xanderhendriks/pcb-tv-slider/README.md

# Starting KiCAD
Run the following command to start the used version of KiCAD:
```bash
docker compose up
```
