xanderhendriks/pcb-tv-slider/kicad/tv_slider.kicad_pcb

## KiCad design kicad/tv_slider.kicad_pcb (2026-07-25)

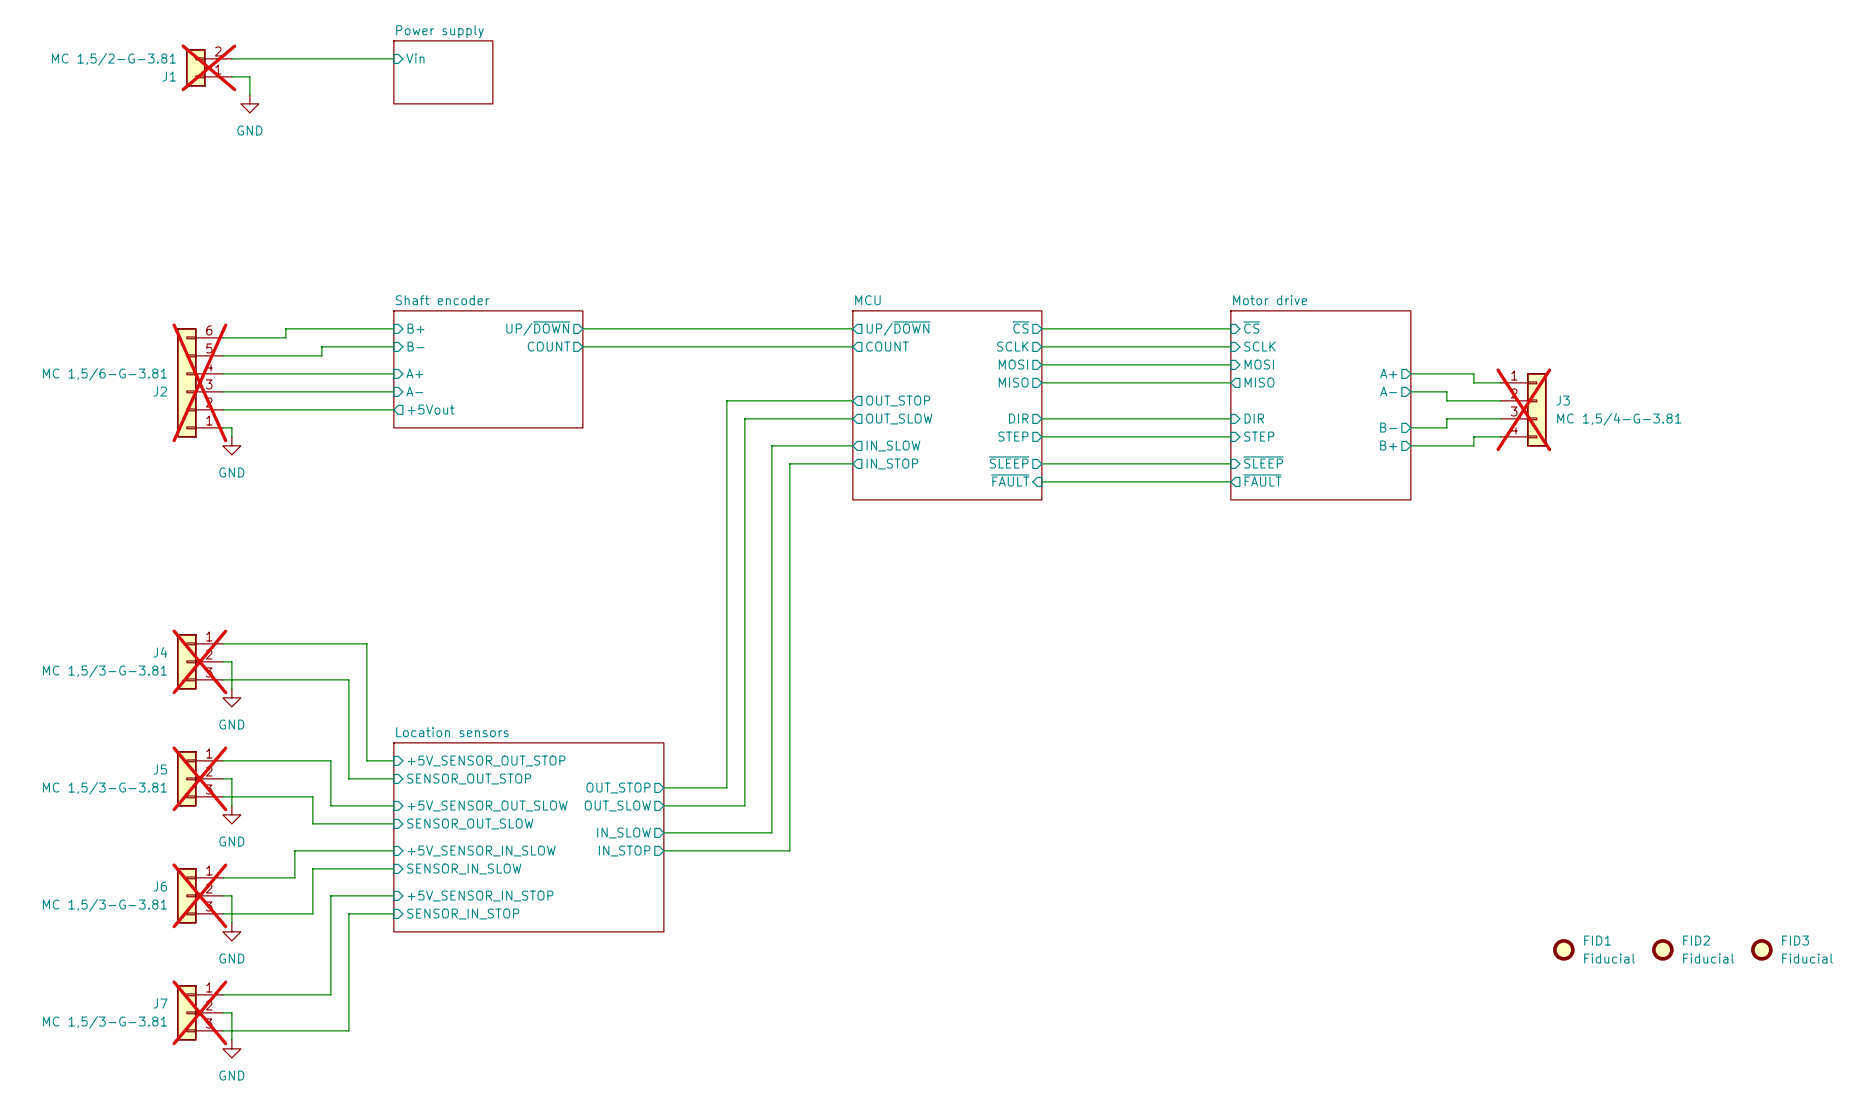
[picture p1: schematic tv_slider.kicad_sch, TV slider]

Parts:
FID1, FID2, FID3: Fiducial; Fiducial_1mm_Mask2mm
J1: MC 1,5/2-G-3.81; PhoenixContact_MC_1,5_2-G-3.81_1x02_P3.81mm_Horizontal; LCSC C480537; not fitted
J2: MC 1,5/6-G-3.81; PhoenixContact_MC_1,5_6-G-3.81_1x06_P3.81mm_Horizontal; LCSC C480580; not fitted
J3: MC 1,5/4-G-3.81; PhoenixContact_MC_1,5_4-G-3.81_1x04_P3.81mm_Horizontal; LCSC C480536; not fitted
J4, J5, J6, J7: MC 1,5/3-G-3.81; PhoenixContact_MC_1,5_3-G-3.81_1x03_P3.81mm_Horizontal; LCSC C480530; not fitted

Connections:
/Location sensors/+5V_SENSOR_IN_SLOW: J6.1; also elsewhere on the board
/Location sensors/+5V_SENSOR_IN_STOP: J7.1; also elsewhere on the board
/Location sensors/+5V_SENSOR_OUT_SLOW: J5.1; also elsewhere on the board
/Location sensors/+5V_SENSOR_OUT_STOP: J4.1; also elsewhere on the board
/Location sensors/SENSOR_IN_SLOW: J6.3; also elsewhere on the board
/Location sensors/SENSOR_IN_STOP: J7.3; also elsewhere on the board
/Location sensors/SENSOR_OUT_SLOW: J5.3; also elsewhere on the board
/Location sensors/SENSOR_OUT_STOP: J4.3; also elsewhere on the board
/Motor drive/A+: J3.1; also elsewhere on the board
/Motor drive/A-: J3.2; also elsewhere on the board
/Motor drive/B+: J3.4; also elsewhere on the board
/Motor drive/B-: J3.3; also elsewhere on the board
/Power supply/Vin: J1.2; also elsewhere on the board
/Shaft encoder/+5Vout: J2.2; also elsewhere on the board
/Shaft encoder/A+: J2.4; also elsewhere on the board
/Shaft encoder/A-: J2.3; also elsewhere on the board
/Shaft encoder/B+: J2.6; also elsewhere on the board
/Shaft encoder/B-: J2.5; also elsewhere on the board
GND: J1.1, J2.1, J4.2, J5.2, J6.2, J7.2; also elsewhere on the board

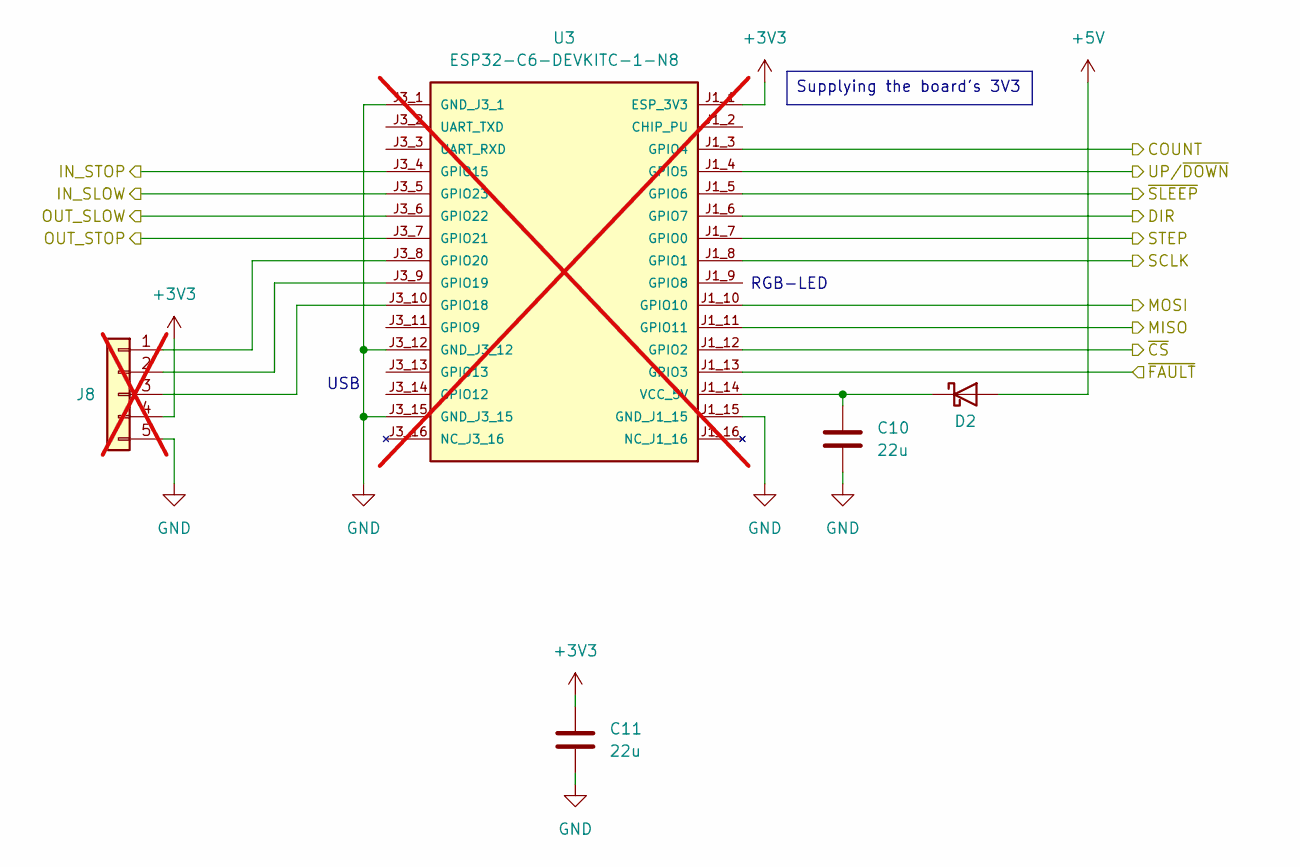
[picture p2: schematic mcu.kicad_sch, TV slider]

Parts:
C10, C11: 22u; C_1206_3216Metric; Voltage 25V; LCSC C12891
D2: 1N5819WS; D_SOD-323; Voltage 40V; LCSC C191023
J8: Conn_01x05; PinHeader_1x05_P2.54mm_Vertical; LCSC C6461551; not fitted
U3: ESP32-C6-DEVKITC-1-N8; MODULE_ESP32-C6-DEVKITC-1-N8; PARTREV 1.3; LCSC C20554022; not fitted

Connections:
+3V3: C11.1, J8.4, U3.J1_1 (ESP_3V3); also elsewhere on the board
+5V: D2.2 (A); also elsewhere on the board
/Location sensors/IN_SLOW: U3.J3_5 (GPIO23); also elsewhere on the board
/Location sensors/IN_STOP: U3.J3_4 (GPIO15); also elsewhere on the board
/Location sensors/OUT_SLOW: U3.J3_6 (GPIO22); also elsewhere on the board
/Location sensors/OUT_STOP: U3.J3_7 (GPIO21); also elsewhere on the board
/MCU/COUNT: U3.J1_3 (GPIO4); also elsewhere on the board
/MCU/DIR: U3.J1_6 (GPIO7); also elsewhere on the board
/MCU/MISO: U3.J1_11 (GPIO11); also elsewhere on the board
/MCU/MOSI: U3.J1_10 (GPIO10); also elsewhere on the board
/MCU/SCLK: U3.J1_8 (GPIO1); also elsewhere on the board
/MCU/STEP: U3.J1_7 (GPIO0); also elsewhere on the board
/MCU/UP/~DOWN: U3.J1_4 (GPIO5); also elsewhere on the board
/MCU/~CS: U3.J1_12 (GPIO2); also elsewhere on the board
/MCU/~FAULT: U3.J1_13 (GPIO3); also elsewhere on the board
/MCU/~SLEEP: U3.J1_5 (GPIO6); also elsewhere on the board
GND: C10.2, C11.2, J8.5, U3.J1_15 (GND_J1_15), U3.J3_1 (GND_J3_1), U3.J3_12 (GND_J3_12), U3.J3_15 (GND_J3_15); also elsewhere on the board
unnamed: C10.1, D2.1 (K), U3.J1_14 (VCC_5V)
unnamed: J8.1, U3.J3_8 (GPIO20)
unnamed: J8.2, U3.J3_9 (GPIO19)
unnamed: J8.3, U3.J3_10 (GPIO18)

Notes on the sheet:
USB
RGB-LED
Supplying the board's 3V3

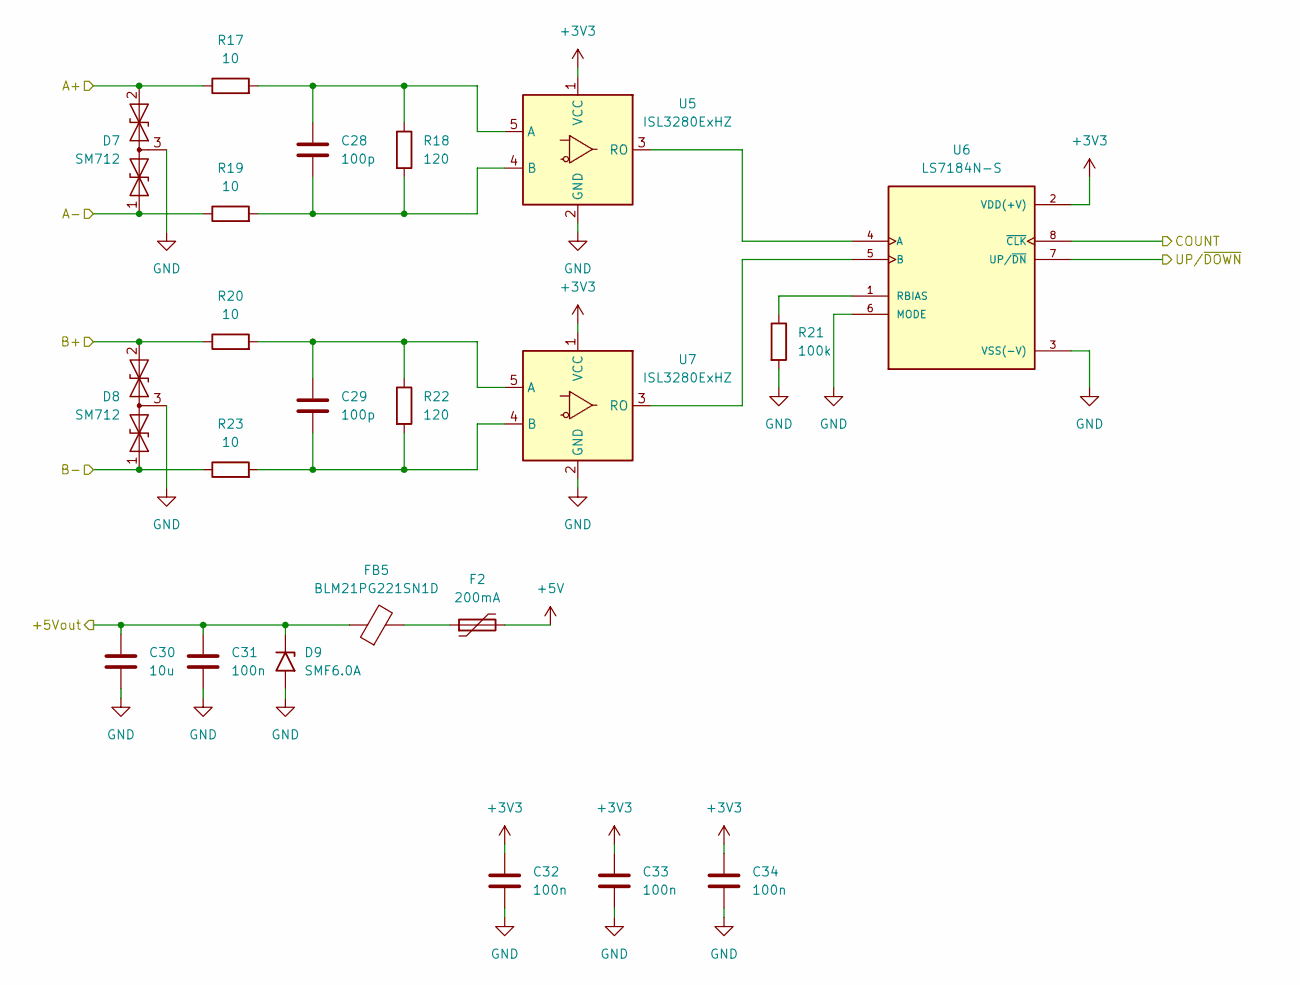
[picture p3: schematic shaft_encoder.kicad_sch, TV slider]

Parts:
C28, C29: 100p; C_0603_1608Metric; Voltage 50V; LCSC C14858
C30: 10u; C_0805_2012Metric; Voltage 50V; LCSC C440198
C31, C32, C33, C34: 100n; C_0603_1608Metric; Voltage 50V; LCSC C14663
D7, D8: SM712; SOT-23; LCSC C7420375
D9: SMF6.0A; D_SOD-123F; Voltage 10.3V; LCSC C19077499
F2: 200mA; Fuse_1206_3216Metric; LCSC C207035
FB5: BLM21PG221SN1D; L_0805_2012Metric; LCSC C1015
R17, R19, R20, R23: 10; R_0603_1608Metric; LCSC C22859
R18, R22: 120; R_0603_1608Metric; LCSC C22787
R21: 100k; R_0603_1608Metric; LCSC C25803
U5, U7: ISL3280ExHZ; SOT-23-5; LCSC C3227945
U6: LS7184N-S; SOIC127P600X175-8N; PARTREV June 2015; LCSC C3234980

Connections:
+3V3: C32.1, C33.1, C34.1, U5.1 (VCC), U6.2 (VDD(+V)), U7.1 (VCC); also elsewhere on the board
+5V: F2.2; also elsewhere on the board
/MCU/COUNT: U6.8 (~CLK); also elsewhere on the board
/MCU/UP/~DOWN: U6.7 (UP/~DN); also elsewhere on the board
/Shaft encoder/+5Vout: C30.1, C31.1, D9.1 (A1), FB5.1; also elsewhere on the board
/Shaft encoder/A+: D7.2 (A2), R17.1; also elsewhere on the board
/Shaft encoder/A-: D7.1 (A1), R19.1; also elsewhere on the board
/Shaft encoder/B+: D8.2 (A2), R20.1; also elsewhere on the board
/Shaft encoder/B-: D8.1 (A1), R23.1; also elsewhere on the board
GND: C30.2, C31.2, C32.2, C33.2, C34.2, D7.3 (common), D8.3 (common), D9.2 (A2), R21.2, U5.2 (GND), U6.3 (VSS(-V)), U6.6 (MODE), U7.2 (GND); also elsewhere on the board
unnamed: F2.1, FB5.2
unnamed: C28.1, R17.2, R18.1, U5.5 (A)
unnamed: C28.2, R18.2, R19.2, U5.4 (B)
unnamed: U5.3 (RO), U6.4 (A)
unnamed: U6.5 (B), U7.3 (RO)
unnamed: R21.1, U6.1 (RBIAS)
unnamed: C29.1, R20.2, R22.1, U7.5 (A)
unnamed: C29.2, R22.2, R23.2, U7.4 (B)

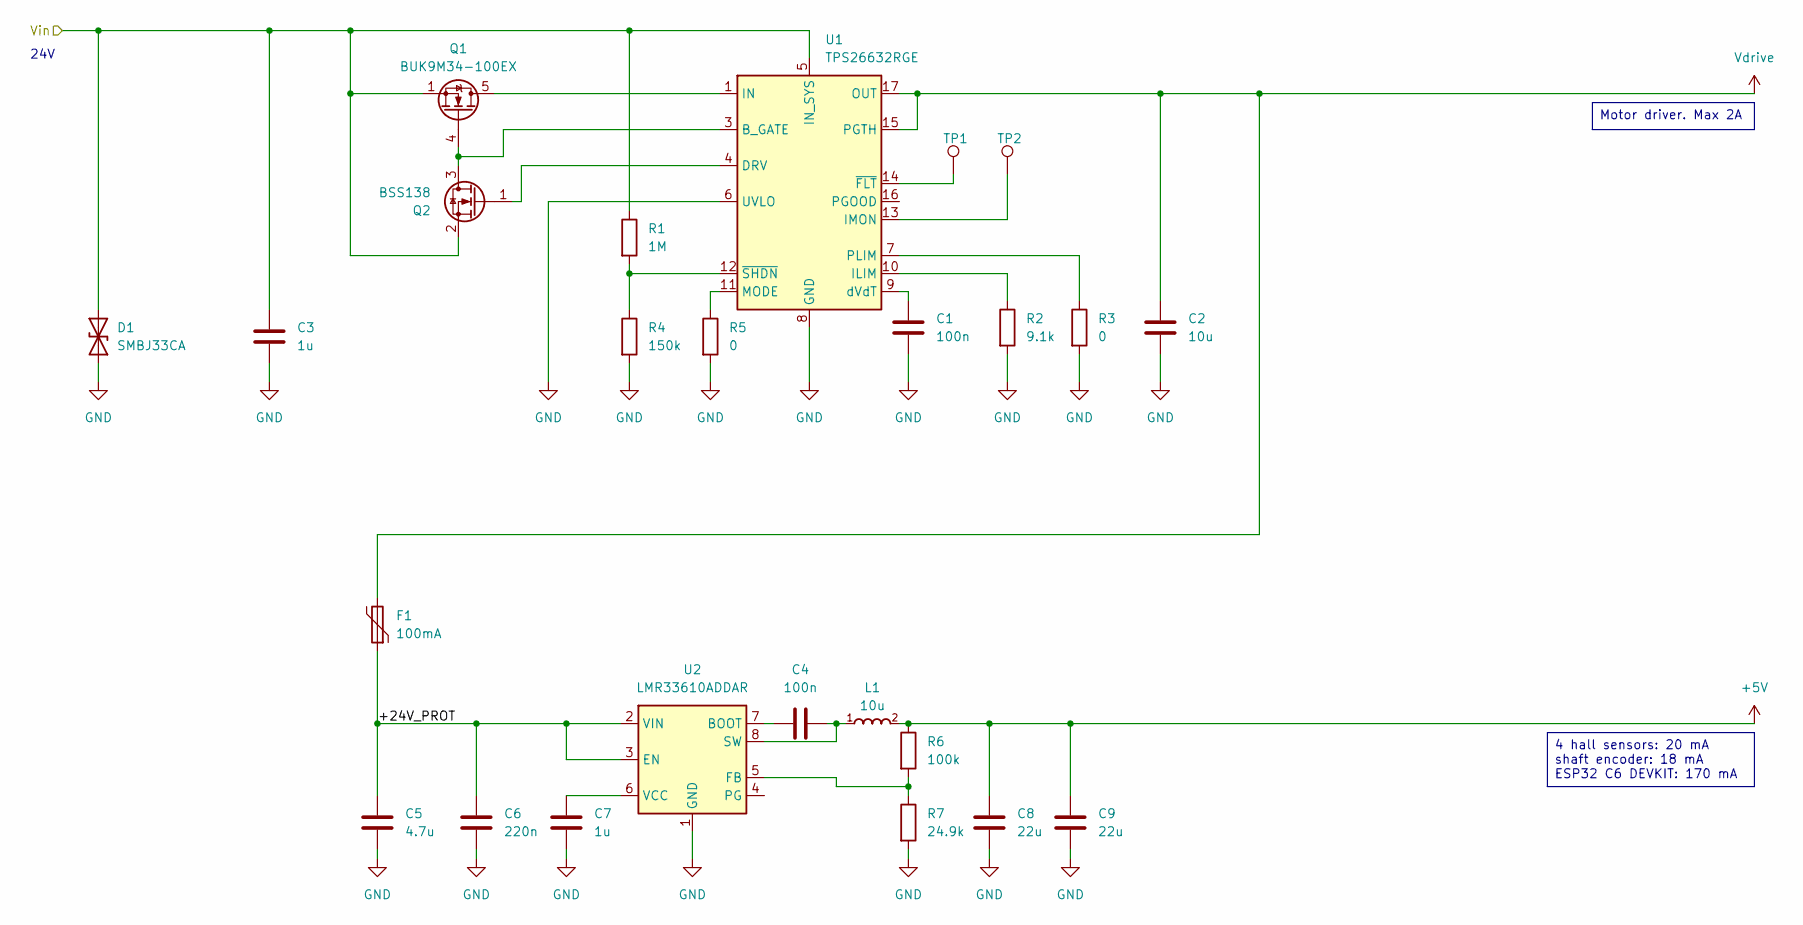
[picture p4: schematic power_supply.kicad_sch, TV slider]

Parts:
C1, C4: 100n; C_0603_1608Metric; Voltage 50V; LCSC C14663
C2: 10u; C_0805_2012Metric; Voltage 50V; LCSC C440198
C3, C7: 1u; C_0603_1608Metric; Voltage 50V; LCSC C15849
C5: 4.7u; C_0805_2012Metric; Voltage 50V; LCSC C162420
C6: 220n; C_0603_1608Metric; Voltage 50V; LCSC C64705
C8, C9: 22u; C_1206_3216Metric; Voltage 25V; LCSC C12891
D1: SMBJ33CA; D_SMB; Voltage 33V; LCSC C19077587
F1: 100mA; Fuse_1812_4532Metric; LCSC C12430
L1: 10u; IND_SRP4020TA-100M; LCSC C2847473
Q1: BUK9M34-100EX; LFPAK33; LCSC C550016
Q2: BSS138; SOT-23; LCSC C7420339
R1: 1M; R_0603_1608Metric; LCSC C22935
R2: 9.1k; R_0603_1608Metric; LCSC C23260
R3, R5: 0; R_0603_1608Metric; LCSC C21189
R4: 150k; R_0603_1608Metric; LCSC C22807
R6: 100k; R_0603_1608Metric; LCSC C25803
R7: 24.9k; R_0603_1608Metric; LCSC C25962
TP1: ~{FLT}; TestPoint_Pad_D1.0mm
TP2: IMON; TestPoint_Pad_D1.0mm
U1: TPS26632RGE; Texas_RGE0024H_VQFN-24-1EP_4x4mm_P0.5mm_EP2.7x2.7mm_Thermal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; LCSC C2862529
U2: LMR33610ADDAR; Texas_HSOP-8-1EP_3.9x4.9mm_P1.27mm_ThermalVias; LCSC C1852147

Connections:
+5V: C8.1, C9.1, L1.2, R6.1; also elsewhere on the board
/Power supply/+24V_PROT: C5.1, C6.1, F1.1, U2.2 (VIN), U2.3 (EN)
/Power supply/Vin: C3.1, D1.2 (A2), Q1.1 (S), Q1.2 (S), Q1.3 (S), Q2.2 (S), R1.1, U1.5 (IN_SYS); also elsewhere on the board
GND: C1.2, C2.2, C3.2, C5.2, C6.2, C7.2, C8.2, C9.2, D1.1 (A1), R2.2, R3.2, R4.2, R5.2, R7.2, U1.6 (UVLO), U1.8 (GND), U1.25 (GND), U2.1 (GND), U2.9 (GND); also elsewhere on the board
unnamed: Q1.5 (D), U1.1 (IN), U1.2 (IN)
unnamed: Q1.4 (G), Q2.3 (D), U1.3 (B_GATE)
unnamed: Q2.1 (G), U1.4 (DRV)
unnamed: R2.1, U1.10 (ILIM)
unnamed: TP2.1, U1.13 (IMON)
unnamed: R5.1, U1.11 (MODE)
unnamed: R3.1, U1.7 (PLIM)
unnamed: C1.1, U1.9 (dVdT)
unnamed: TP1.1, U1.14 (~FLT)
unnamed: R1.2, R4.1, U1.12 (~SHDN)
unnamed: C4.1, U2.7 (BOOT)
unnamed: R6.2, R7.1, U2.5 (FB)
unnamed: C4.2, L1.1, U2.8 (SW)
unnamed: C7.1, U2.6 (VCC)
Vdrive: C2.1, F1.2, U1.15 (PGTH), U1.17 (OUT), U1.18 (OUT); also elsewhere on the board

Notes on the sheet:
24V
4 hall sensors: 20 mA shaft encoder: 18 mA ESP32 C6 DEVKIT: 170 mA
Motor driver. Max 2A

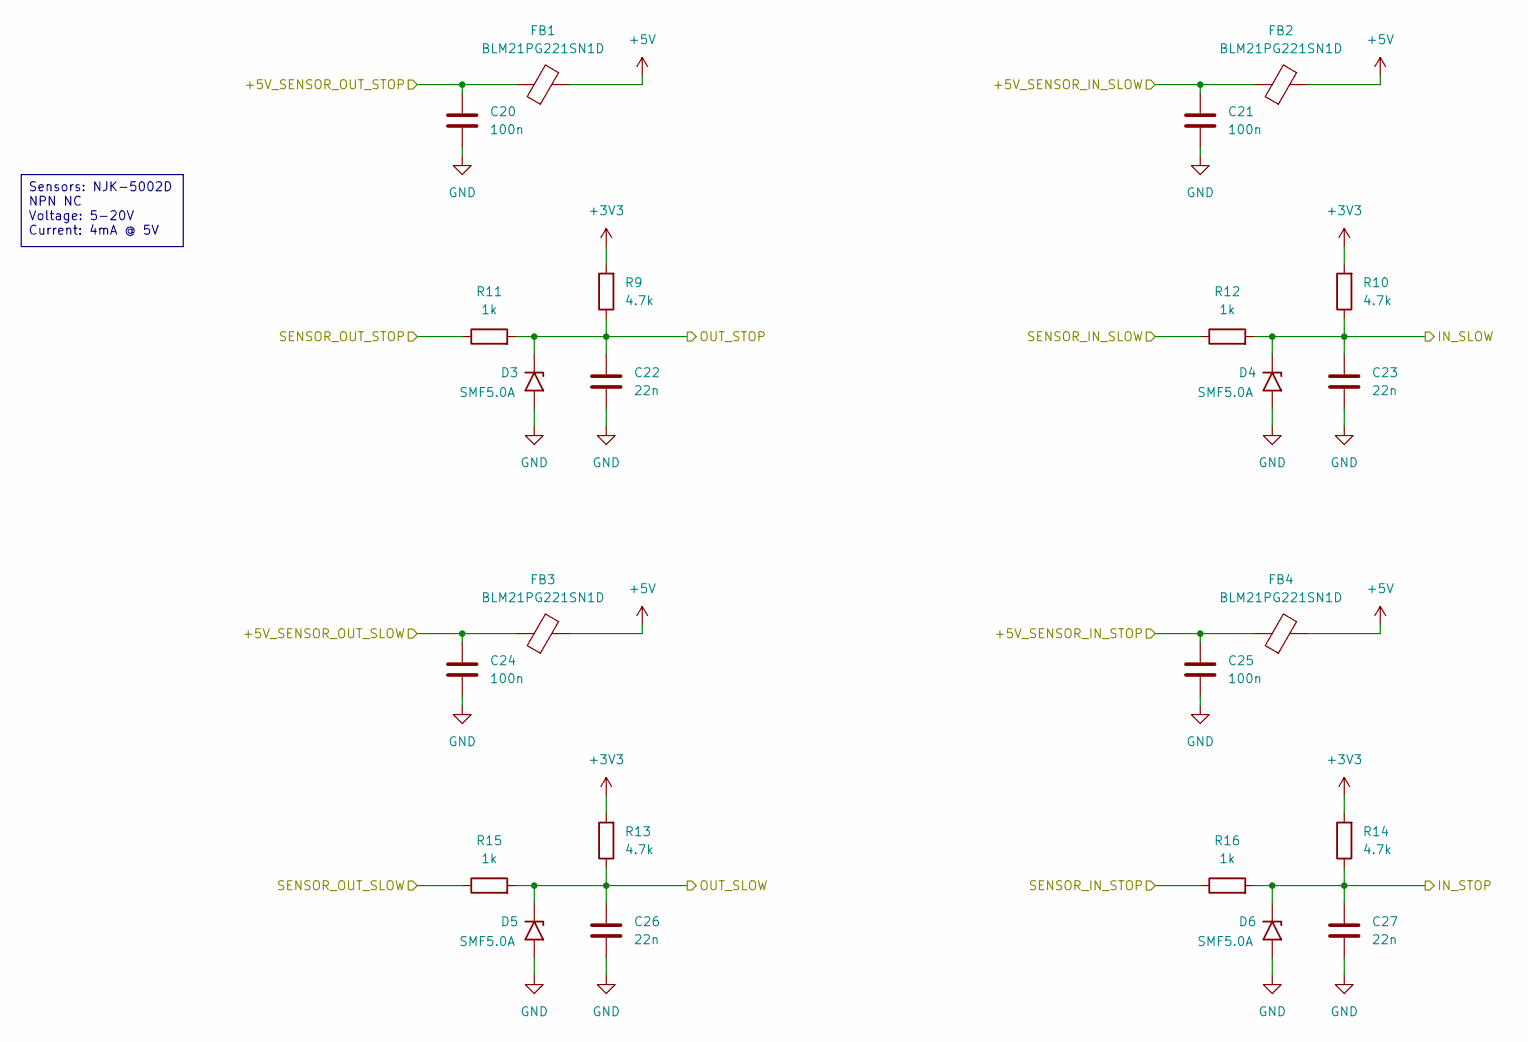
[picture p5: schematic location_sensors.kicad_sch, TV slider]

Parts:
C20, C21, C24, C25: 100n; C_0603_1608Metric; Voltage 50V; LCSC C14663
C22, C23, C26, C27: 22n; C_0603_1608Metric; Voltage 50V; LCSC C21122
D3, D4, D5, D6: SMF5.0A; D_SOD-123F; Voltage 9.2V; LCSC C19077497
FB1, FB2, FB3, FB4: BLM21PG221SN1D; L_0805_2012Metric; LCSC C1015
R9, R10, R13, R14: 4.7k; R_0603_1608Metric; LCSC C23162
R11, R12, R15, R16: 1k; R_0603_1608Metric; LCSC C21190

Connections:
+3V3: R9.2, R10.2, R13.2, R14.2; also elsewhere on the board
+5V: FB1.2, FB2.2, FB3.2, FB4.2; also elsewhere on the board
/Location sensors/+5V_SENSOR_IN_SLOW: C21.1, FB2.1; also elsewhere on the board
/Location sensors/+5V_SENSOR_IN_STOP: C25.1, FB4.1; also elsewhere on the board
/Location sensors/+5V_SENSOR_OUT_SLOW: C24.1, FB3.1; also elsewhere on the board
/Location sensors/+5V_SENSOR_OUT_STOP: C20.1, FB1.1; also elsewhere on the board
/Location sensors/IN_SLOW: C23.1, D4.1 (A1), R10.1, R12.2; also elsewhere on the board
/Location sensors/IN_STOP: C27.1, D6.1 (A1), R14.1, R16.2; also elsewhere on the board
/Location sensors/OUT_SLOW: C26.1, D5.1 (A1), R13.1, R15.2; also elsewhere on the board
/Location sensors/OUT_STOP: C22.1, D3.1 (A1), R9.1, R11.2; also elsewhere on the board
/Location sensors/SENSOR_IN_SLOW: R12.1; also elsewhere on the board
/Location sensors/SENSOR_IN_STOP: R16.1; also elsewhere on the board
/Location sensors/SENSOR_OUT_SLOW: R15.1; also elsewhere on the board
/Location sensors/SENSOR_OUT_STOP: R11.1; also elsewhere on the board
GND: C20.2, C21.2, C22.2, C23.2, C24.2, C25.2, C26.2, C27.2, D3.2 (A2), D4.2 (A2), D5.2 (A2), D6.2 (A2); also elsewhere on the board

Notes on the sheet:
Sensors: NJK-5002D NPN NC Voltage: 5-20V Current: 4mA @ 5V

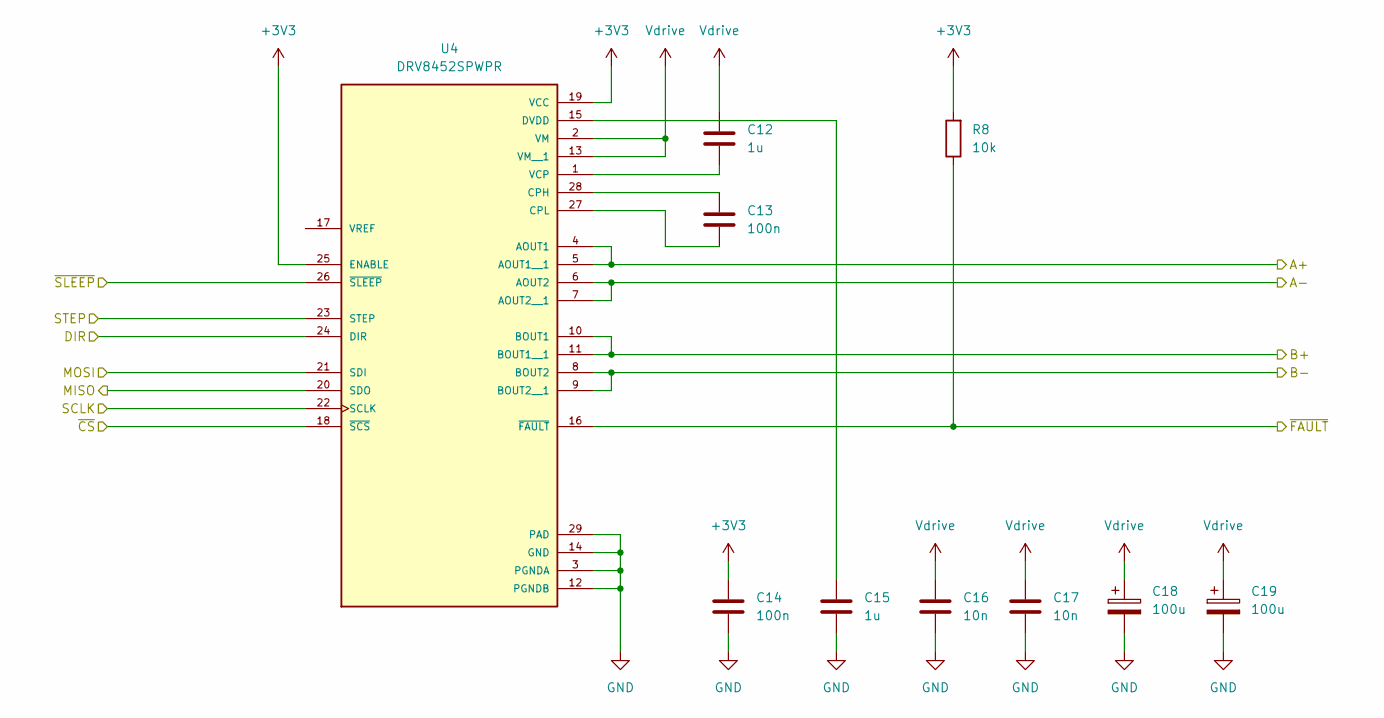
[picture p6: schematic motor_drive.kicad_sch, TV slider]

Parts:
C12, C15: 1u; C_0805_2012Metric; Voltage 50V; LCSC C28323
C13, C14: 100n; C_0603_1608Metric; Voltage 50V; LCSC C14663
C16, C17: 10n; C_0603_1608Metric; Voltage 50V; LCSC C57112
C18, C19: 100u; CP_Elec_8x11.9; Voltage 50V; LCSC C1517667
R8: 10k; R_0603_1608Metric; LCSC C25804
U4: DRV8452SPWPR; IC_DRV8452SPWPR; PARTREV B; LCSC C32469576

Connections:
+3V3: C14.1, R8.2, U4.19 (VCC), U4.25 (ENABLE); also elsewhere on the board
/MCU/DIR: U4.24 (DIR); also elsewhere on the board
/MCU/MISO: U4.20 (SDO); also elsewhere on the board
/MCU/MOSI: U4.21 (SDI); also elsewhere on the board
/MCU/SCLK: U4.22 (SCLK); also elsewhere on the board
/MCU/STEP: U4.23 (STEP); also elsewhere on the board
/MCU/~CS: U4.18 (~SCS); also elsewhere on the board
/MCU/~FAULT: R8.1, U4.16 (~FAULT); also elsewhere on the board
/MCU/~SLEEP: U4.26 (~SLEEP); also elsewhere on the board
/Motor drive/A+: U4.4 (AOUT1), U4.5 (AOUT1__1); also elsewhere on the board
/Motor drive/A-: U4.6 (AOUT2), U4.7 (AOUT2__1); also elsewhere on the board
/Motor drive/B+: U4.10 (BOUT1), U4.11 (BOUT1__1); also elsewhere on the board
/Motor drive/B-: U4.8 (BOUT2), U4.9 (BOUT2__1); also elsewhere on the board
GND: C14.2, C15.2, C16.2, C17.2, C18.2, C19.2, U4.3 (PGNDA), U4.12 (PGNDB), U4.14 (GND), U4.29 (PAD); also elsewhere on the board
unnamed: C13.1, U4.28 (CPH)
unnamed: C13.2, U4.27 (CPL)
unnamed: C15.1, U4.15 (DVDD)
unnamed: C12.2, U4.1 (VCP)
Vdrive: C12.1, C16.1, C17.1, C18.1, C19.1, U4.2 (VM), U4.13 (VM__1); also elsewhere on the board

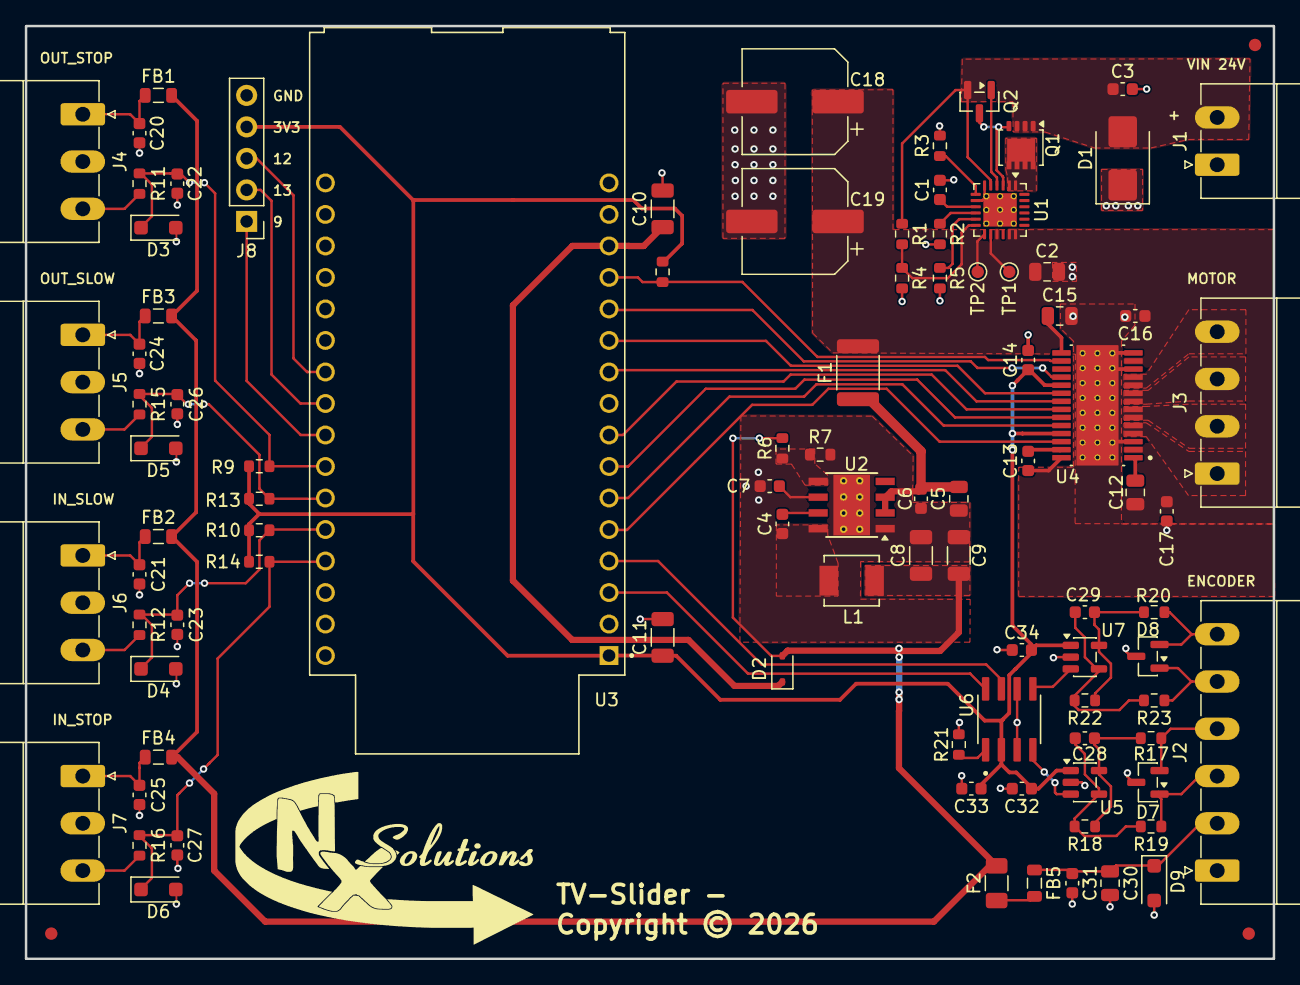
[picture p7: board tv_slider.kicad_pcb from above]

Board: 2 copper layers, 100.6 x 75.2 mm, 96 parts (0 on the bottom side), 67 nets.
