xanderhendriks/pcb-tv-slider/(commit log)

2025-09-25 Initial version with just the MCU DevKit
    [tv_slider.kicad_pcb, tv_slider.kicad_sch]
2025-10-04 top level schematic completed
    [location_sensors.kicad_sch, mcu.kicad_sch, motor_drive.kicad_sch, power_supply.kicad_sch, shaft_encoder.kicad_sch, tv_slider.kicad_pcb, tv_slider.kicad_sch]
2025-10-07 Completed the schematic. All components have Digikey part numbers and footprints. The power supply sheet still requires some work.
    [location_sensors.kicad_sch, mcu.kicad_sch, motor_drive.kicad_sch, power_supply.kicad_sch, shaft_encoder.kicad_sch, tv_slider.kicad_pcb, tv_slider.kicad_sch]
2025-10-13 Updated footprints and step models. Placed on PCB, but not yet positioned in final location.
    [location_sensors.kicad_sch, mcu.kicad_sch, motor_drive.kicad_sch, power_supply.kicad_sch, shaft_encoder.kicad_sch, tv_slider.kicad_pcb, tv_slider.kicad_sch]
2025-11-04 Added a compose file to start KiCAD from a docker and a README to explain how to use it.
2025-12-05 Updated all schematic pages except the power supply. Did the initial component placement.
    [location_sensors.kicad_sch, mcu.kicad_sch, motor_drive.kicad_sch, power_supply.kicad_sch, shaft_encoder.kicad_sch, tv_slider.kicad_pcb, tv_slider.kicad_sch]
2025-12-14 Changed power supply chips as the 12V is no longer required.
    [location_sensors.kicad_sch, power_supply.kicad_sch]
2025-12-20 Finished the schematic and started the PCB.
    [location_sensors.kicad_sch, mcu.kicad_sch, motor_drive.kicad_sch, power_supply.kicad_sch, shaft_encoder.kicad_sch, tv_slider.kicad_pcb, tv_slider.kicad_sch]
2025-12-23 Completed the PCB design. Ready for final review.
    [location_sensors.kicad_sch, mcu.kicad_sch, motor_drive.kicad_sch, power_supply.kicad_sch, shaft_encoder.kicad_sch, tv_slider.kicad_pcb, tv_slider.kicad_sch]
2025-12-29 Reviewed the part numbers, footprints and pin numbers.
    [location_sensors.kicad_sch, mcu.kicad_sch, motor_drive.kicad_sch, power_supply.kicad_sch, shaft_encoder.kicad_sch, tv_slider.kicad_pcb, tv_slider.kicad_sch]
2025-12-30 Removed DNP for shaft encoder filtering
    [shaft_encoder.kicad_sch]
2025-12-30 DNP pushed through to PCB
    [tv_slider.kicad_pcb]
2025-12-31 Re-annotated and added extra capacitors for the 5V and 3V3 DC-DC converters. Added testpoints to the electronic fuse.
    [location_sensors.kicad_sch, mcu.kicad_sch, motor_drive.kicad_sch, power_supply.kicad_sch, shaft_encoder.kicad_sch, tv_slider.kicad_pcb]
2026-01-01 Fixed up or explained all DRC violations.
    [location_sensors.kicad_sch, mcu.kicad_sch, motor_drive.kicad_sch, power_supply.kicad_sch, shaft_encoder.kicad_sch, tv_slider.kicad_pcb, tv_slider.kicad_sch]
2026-01-02 Reviewed the ESP32-C6-DEVKIT GPIO's. Some of them have a dual function and are better left untouched.
    [mcu.kicad_sch, motor_drive.kicad_sch, tv_slider.kicad_pcb, tv_slider.kicad_sch]
2026-01-02 Supplying the ESP32-C6-DEVKIT with 5V and using its 3V3 output to supply the boards logic. Removed the 3V3 switch mode power supply on the board.
    [location_sensors.kicad_sch, mcu.kicad_sch, motor_drive.kicad_sch, power_supply.kicad_sch, shaft_encoder.kicad_sch, tv_slider.kicad_pcb]
2026-01-02 Added extra copper for cooling the DRV8452SPWPR motor driver.
    [power_supply.kicad_sch, tv_slider.kicad_pcb]
2026-01-02 Added some extra vias.
    [tv_slider.kicad_pcb]
2026-01-02 Version 1.0 files as send to PCBWay
    [mcu.kicad_sch, tv_slider.kicad_pcb, tv_slider.kicad_sch]
2026-01-04 Updated to use more of JCLPCB's basic components. Added extra field "FT Rotation Offset" to get the correct orientation for placement at JCLPCB.
    [location_sensors.kicad_sch, mcu.kicad_sch, motor_drive.kicad_sch, power_supply.kicad_sch, shaft_encoder.kicad_sch, tv_slider.kicad_pcb, tv_slider.kicad_sch]
2026-01-13 Fixed part number for DNP component.
    [mcu.kicad_sch]
2026-01-13 Fixed rotation for JLCPCB.
    [motor_drive.kicad_sch, power_supply.kicad_sch, tv_slider.kicad_pcb]
2026-07-25 Add github workflow for JLCPCB production files. Updated to KiCAD 10. Removed docker compose file.
    [location_sensors.kicad_sch, mcu.kicad_sch, motor_drive.kicad_sch, power_supply.kicad_sch, shaft_encoder.kicad_sch, tv_slider.kicad_pcb, tv_slider.kicad_sch]
2026-08-14 Fix tag version number in gerber files.
