xanderhendriks/pcb-tv-slider/(notices)

Notices in the files:
kicad/tv_slider.kicad_pcb:
Copyright © 2026
